AlexeyVdovin/ha-proj/SmartNode/eagle/main-01.brd

## EAGLE design SmartNode/eagle/main-01.brd (2019-10-10)

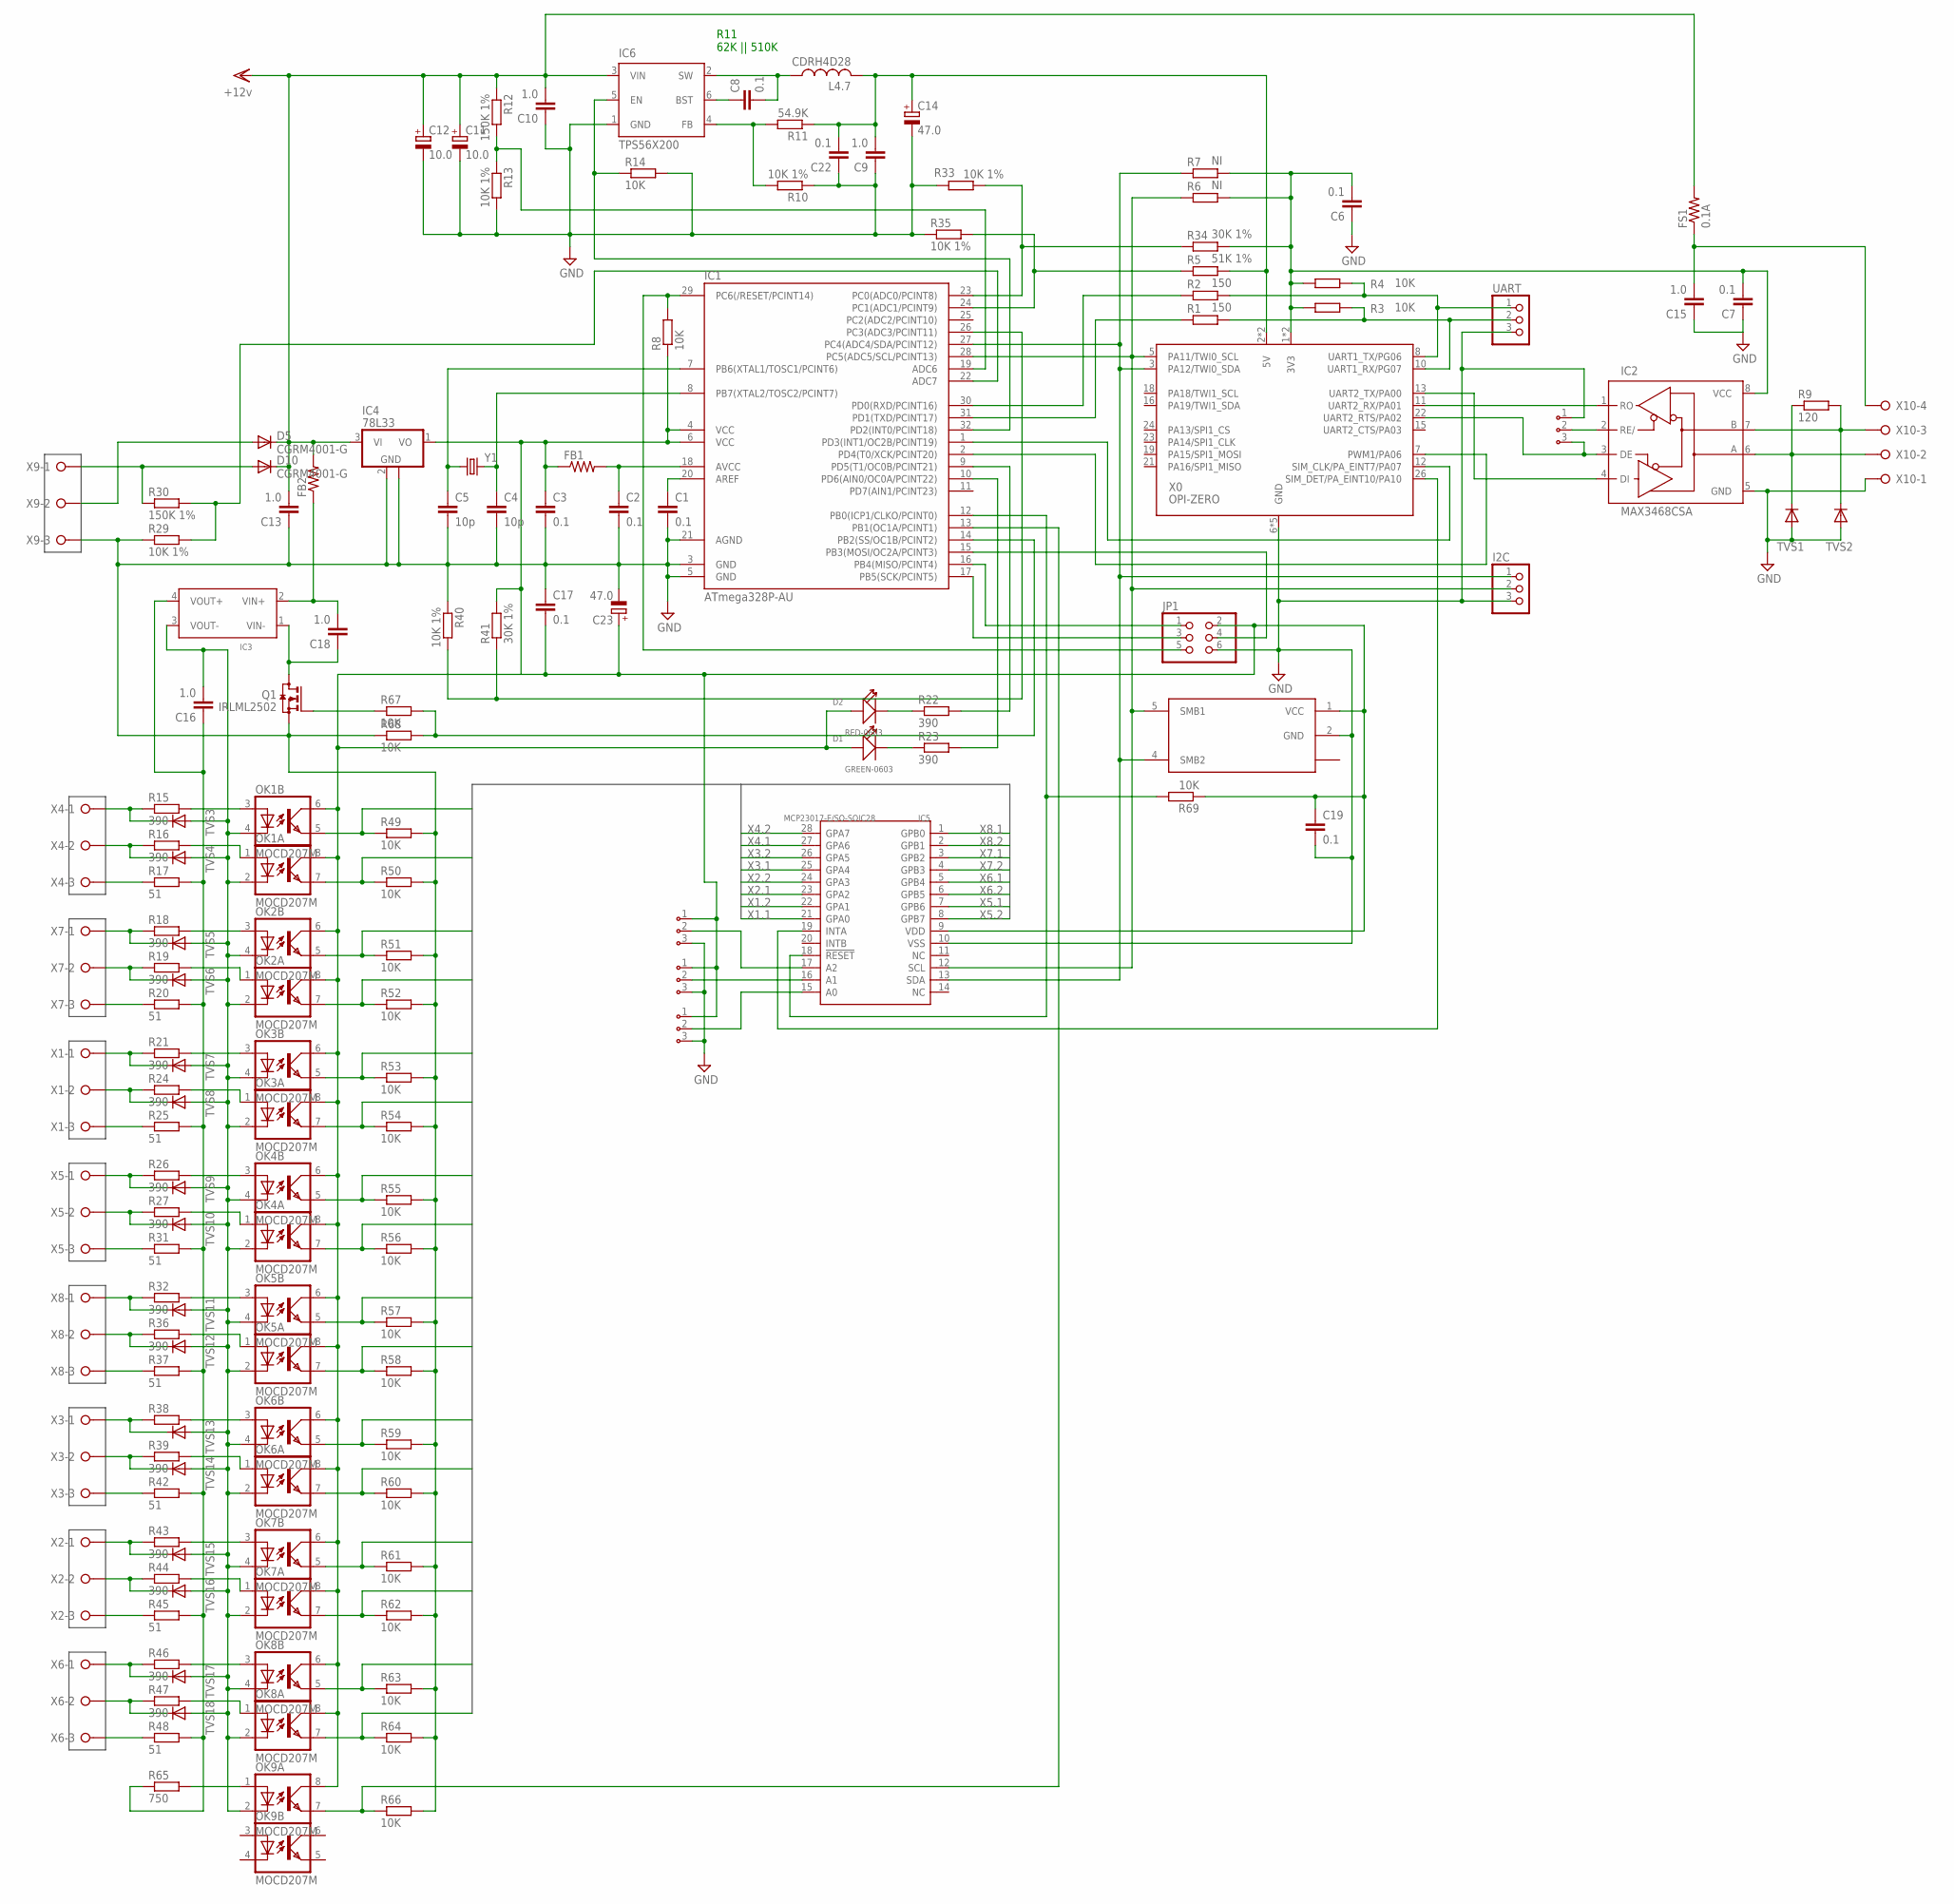
[picture p1: schematic main-01.sch]

Parts:
4: ADDR3PIN0603; 0603-3PIN
A0, A1, A2: ADDR3PIN0603; 0603-3PIN
C1, C2, C3, C17, C19: 0.1; C0603
C4, C5: 10p; C0603
C6, C7, C8, C22: 0.1; C0805
C9: 1.0; C0805
C10, C13, C15, C16, C18: 1.0; C1206
C11, C12: 10.0; C/6032-28R
C14, C23: 47.0; B/3528-21R
D1: GREEN-0603; LED-0603
D2: RED-0603; LED-0603
D5, D10: CGRM4001-G; SOD-123_MINI-SMA
FB1: R-US_R0805; R0805
FB2: R-US_R1206; R1206
FS1: 0.1A; R1210
I2C: PINHD-1X3; 1X03
IC1: ATmega328P-AU; TQFP32-08
IC2: MAX3468CSA; SO08
IC3: DC-DC-CONV-4PIN-ISOLATINGMURATA-NME-05-12-SERIES; DC-DC-MURATA-NME-05-12-SERIES
IC4: 78L33; SOT89
IC5: MCP23017-E/SO-SOIC28; SOIC28-1.27-17.9X7.5MM
IC6: TPS56X200; TSOT23-6_DDC
IC7: LTC1694; SOT23-5
JP1: PINHD-2X3; 2X03
L4.7: CDRH4D28
OK1, OK2, OK3, OK4, OK5, OK6, OK7, OK8, OK9: MOCD207M; SOIC08-FAIRCHILD
Q1: IRLML2502; SOT23
R1, R2: 150; R0603
R3, R4, R8, R14, R49, R50, R51, R52, R53, R54, R55, R56, R57, R58, R59, R60, R61, R62, R63, R64, R66, R67, R68, R69: 10K; R0603
R5: 51K 1%; R0603
R6, R7: NI; R0603
R9: 120; R1206
R10, R13, R29, R33, R35, R40: 10K 1%; R0603
R11: 54.9K; R0603
R12, R30: 150K 1%; R0603
R15, R16, R18, R19, R21, R22, R23, R24, R26, R27, R32, R36, R39, R43, R44, R46, R47: 390; R0603
R17, R20, R25, R31, R37, R42, R45, R48: 51; R0603
R34, R41: 30K 1%; R0603
R38: R-EU_R0603; R0603
R65: 750; R0603
TVS1, TVS2, TVS3, TVS4, TVS5, TVS6, TVS7, TVS8, TVS9, TVS10, TVS11, TVS12, TVS13, TVS14, TVS15, TVS16, TVS17, TVS18: DIODE-SOD323-W; SOD323-W
UART: PINHD-1X3; 1X03
X0: OPI-ZERO; OPI0
X1, X2, X3, X4, X5, X6, X7, X8, X9: W237-03P; W237-133
X10: W237-04P; W237-4P
Y1: CRYSTALHC49US; HC49US

Connections:
12V: C10.2, C11.+, C12.+, C13.2, D5.C, D10.C, FB2.2, FS1.2, IC4.3 (VI), IC6.3 (VIN), R12.1
GND: 4.1, A0.3, A1.3, A2.3, C1.2, C2.2, C3.2, C4.2, C5.2, C6.1, C7.1, C9.1, C10.1, C11.-, C12.-, C13.1, C14.-, C15.1, C17.1, C19.2, C22.1, C23.-, I2C.3, IC1.3 (GND), IC1.5 (GND), IC1.21 (AGND), IC2.5 (GND), IC4.2 (GND), IC4.2@1 (GND), IC5.10 (VSS), IC6.1 (GND), IC7.2 (GND), JP1.6, Q1.2 (S), R10.1, R13.2, R14.2, R29.1, R33.2, R35.1, R40.1, R49.2, R50.2, R51.2, R52.2, R53.2, R54.2, R55.2, R56.2, R57.2, R58.2, R59.2, R60.2, R61.2, R62.2, R63.2, R64.2, R66.2, R68.1, TVS1.A, TVS2.A, UART.3, X0.6 (GND), X0.9 (GND), X0.14 (GND), X0.20 (GND), X0.25 (GND), X9.3, X10.1
unnamed: 4.3, IC2.3 (DE), X0.22 (UART2_RTS/PA02)
unnamed: IC2.1 (RO), X0.11 (UART2_RX/PA01)
unnamed: C8.2, IC6.2 (SW), L4.7.P$1 (1)
unnamed: C4.1, IC1.8 (PB7(XTAL2/TOSC2/PCINT7)), Y1.2
unnamed: IC1.30 (PD0(RXD/PCINT16)), R2.1
unnamed: IC1.31 (PD1(TXD/PCINT17)), R1.1
unnamed: R1.2, R3.2, UART.2, X0.10 (UART1_RX/PG07)
unnamed: R2.2, R4.2, UART.1, X0.8 (UART1_TX/PG06)
unnamed: IC2.4 (DI), X0.13 (UART2_TX/PA00)
unnamed: C5.1, IC1.7 (PB6(XTAL1/TOSC1/PCINT6)), Y1.1
unnamed: IC1.24 (PC1(ADC1/PCINT9)), R5.1, R35.2
unnamed: D5.A, X9.2
unnamed: IC1.29 (PC6(/RESET/PCINT14)), JP1.5, R8.2
unnamed: OK1.3 (A), R15.2
unnamed: C1.1, IC1.20 (AREF)
unnamed: C2.1, FB1.2, IC1.18 (AVCC)
unnamed: C8.1, IC6.6 (BST)
unnamed: IC1.15 (PB3(MOSI/OC2A/PCINT3)), JP1.4
unnamed: IC1.17 (PB5(SCK/PCINT5)), JP1.3
unnamed: IC1.16 (PB4(MISO/PCINT4)), JP1.1
unnamed: IC2.6 (A), R9.1, TVS1.C, X10.2
unnamed: IC6.4 (FB), R10.2, R11.2
unnamed: IC2.7 (B), R9.2, TVS2.C, X10.3
unnamed: C15.2, FS1.1, X10.4
unnamed: IC1.19 (ADC6), R12.2, R13.1
unnamed: R15.1, TVS3.C, X4.1
unnamed: IC1.32 (PD2(INT0/PCINT18)), IC6.5 (EN), R14.1
unnamed: R16.1, TVS4.C, X4.2
unnamed: IC1.1 (PD3(INT1/OC2B/PCINT19)), X0.12 (SIM_CLK/PA_EINT7/PA07)
unnamed: R17.1, X4.3
unnamed: D10.A, R30.1, X9.1
unnamed: R18.1, TVS5.C, X7.1
unnamed: R19.1, TVS6.C, X7.2
unnamed: R20.1, X7.3
unnamed: OK2.3 (A), R18.2
unnamed: R21.1, TVS7.C, X1.1
unnamed: IC1.10 (PD6(AIN0/OC0A/PCINT22)), R23.2
unnamed: IC1.9 (PD5(T1/OC0B/PCINT21)), R22.2
unnamed: OK3.3 (A), R21.2
unnamed: R24.1, TVS8.C, X1.2
unnamed: R25.1, X1.3
unnamed: R26.1, TVS9.C, X5.1
unnamed: R27.1, TVS10.C, X5.2
unnamed: R31.1, X5.3
unnamed: R32.1, TVS11.C, X8.1
unnamed: R36.1, TVS12.C, X8.2
unnamed: R37.1, X8.3
unnamed: R38.1, TVS13.C, X3.1
unnamed: R39.1, TVS14.C, X3.2
unnamed: R42.1, X3.3
unnamed: R43.1, TVS15.C, X2.1
unnamed: R44.1, TVS16.C, X2.2
unnamed: R45.1, X2.3
unnamed: R46.1, TVS17.C, X6.1
unnamed: R47.1, TVS18.C, X6.2
unnamed: R48.1, X6.3
unnamed: OK4.3 (A), R26.2
unnamed: OK5.3 (A), R32.2
unnamed: OK6.3 (A), R38.2
unnamed: OK7.3 (A), R43.2
unnamed: IC1.22 (ADC7), R29.2, R30.2
unnamed: OK8.3 (A), R46.2
unnamed: C16.1, IC3.4 (VOUT+), R17.2, R20.2, R25.2, R31.2, R37.2, R42.2, R45.2, R48.2, R65.1
unnamed: IC1.23 (PC0(ADC0/PCINT8)), R33.1, R34.1
unnamed: OK1.1 (A), R16.2
unnamed: OK2.1 (A), R19.2
unnamed: OK3.1 (A), R24.2
unnamed: IC1.26 (PC3(ADC3/PCINT11)), R40.2, R41.1
unnamed: OK4.1 (A), R27.2
unnamed: OK5.1 (A), R36.2
unnamed: OK6.1 (A), R39.2
unnamed: OK7.1 (A), R44.2
unnamed: OK8.1 (A), R47.2
unnamed: C16.2, IC3.3 (VOUT-), OK1.2 (C), OK1.4 (C), OK2.2 (C), OK2.4 (C), OK3.2 (C), OK3.4 (C), OK4.2 (C), OK4.4 (C), OK5.2 (C), OK5.4 (C), OK6.2 (C), OK6.4 (C), OK7.2 (C), OK7.4 (C), OK8.2 (C), OK8.4 (C), OK9.2 (C), TVS3.A, TVS4.A, TVS5.A, TVS6.A, TVS7.A, TVS8.A, TVS9.A, TVS10.A, TVS11.A, TVS12.A, TVS13.A, TVS14.A, TVS15.A, TVS16.A, TVS17.A, TVS18.A
unnamed: D2.-, R22.1
unnamed: 4.2, IC2.2 (RE/)
unnamed: IC1.2 (PD4(T0/XCK/PCINT20)), X0.7 (PWM1/PA06)
unnamed: IC5.19 (INTA), X0.26 (SIM_DET/PA_EINT10/PA10)
unnamed: OK9.1 (A), R65.2
unnamed: IC1.13 (PB1(OC1A/PCINT1)), OK9.7 (EMIT), R66.1
unnamed: Q1.1 (G), R67.1
unnamed: IC1.14 (PB2(SS/OC1B/PCINT2)), R67.2, R68.2
unnamed: C18.1, IC3.1 (VIN-), Q1.3 (D)
unnamed: C18.2, FB2.1, IC3.2 (VIN+)
unnamed: IC1.12 (PB0(ICP1/CLKO/PCINT0)), IC5.18 (!RESET), R69.2
unnamed: A0.2, IC5.15 (A0)
unnamed: A1.2, IC5.16 (A1)
unnamed: A2.2, IC5.17 (A2)
unnamed: D1.-, R23.1
SCL: I2C.2, IC1.28 (PC5(ADC5/SCL/PCINT13)), IC5.12 (SCL), IC7.5 (SMB1), R6.1, X0.5 (PA11/TWI0_SCL)
SDA: I2C.1, IC1.27 (PC4(ADC4/SDA/PCINT12)), IC5.13 (SDA), IC7.4 (SMB2), R7.1, X0.3 (PA12/TWI0_SDA)
VCC: A0.1, A1.1, A2.1, C3.1, C17.2, C19.1, C23.+, D1.+, D2.+, FB1.1, IC1.4 (VCC), IC1.6 (VCC), IC4.1 (VO), IC5.9 (VDD), IC7.1 (VCC), JP1.2, OK1.6 (COL), OK1.8 (COL), OK2.6 (COL), OK2.8 (COL), OK3.6 (COL), OK3.8 (COL), OK4.6 (COL), OK4.8 (COL), OK5.6 (COL), OK5.8 (COL), OK6.6 (COL), OK6.8 (COL), OK7.6 (COL), OK7.8 (COL), OK8.6 (COL), OK8.8 (COL), OK9.8 (COL), R8.1, R41.2, R69.1
X1.1: IC5.21 (GPA0), OK3.5 (EMIT), R53.1
X1.2: IC5.22 (GPA1), OK3.7 (EMIT), R54.1
X2.1: IC5.23 (GPA2), OK7.5 (EMIT), R61.1
X2.2: IC5.24 (GPA3), OK7.7 (EMIT), R62.1
X3.1: IC5.25 (GPA4), OK6.5 (EMIT), R59.1
X3.2: IC5.26 (GPA5), OK6.7 (EMIT), R60.1
X4.1: IC5.27 (GPA6), OK1.5 (EMIT), R49.1
X4.2: IC5.28 (GPA7), OK1.7 (EMIT), R50.1
X5.1: IC5.7 (GPB6), OK4.5 (EMIT), R55.1
X5.2: IC5.8 (GPB7), OK4.7 (EMIT), R56.1
X6.1: IC5.5 (GPB4), OK8.5 (EMIT), R63.1
X6.2: IC5.6 (GPB5), OK8.7 (EMIT), R64.1
X7.1: IC5.3 (GPB2), OK2.5 (EMIT), R51.1
X7.2: IC5.4 (GPB3), OK2.7 (EMIT), R52.1
X8.1: IC5.1 (GPB0), OK5.5 (EMIT), R57.1
X8.2: IC5.2 (GPB1), OK5.7 (EMIT), R58.1
Z3V3: C6.2, C7.2, IC2.8 (VCC), R3.1, R4.1, R6.2, R7.2, R34.2, X0.1 (3V3), X0.17 (3V3)
Z5V: C9.2, C14.+, C22.2, L4.7.P$2 (2), R5.2, R11.1, X0.2 (5V), X0.4 (5V)

Notes on the sheet:
R11 62K || 510K

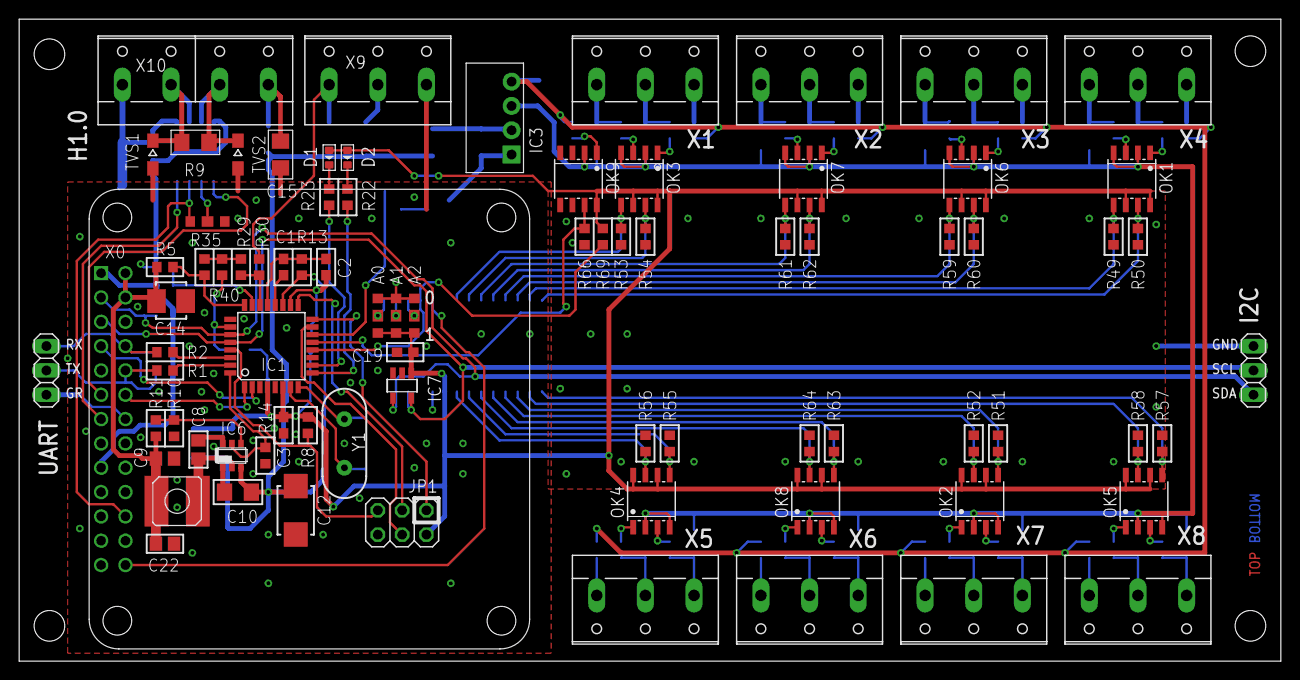
[picture p2: board main-01.brd from above]

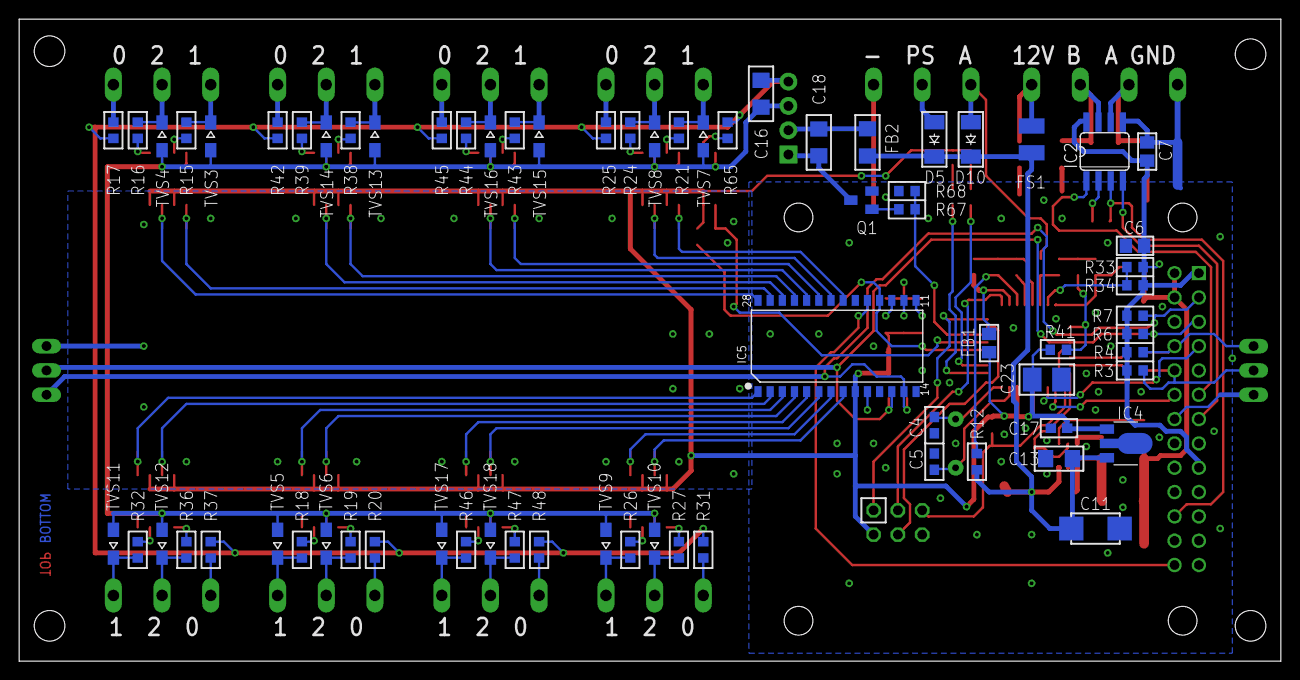
[picture p3: board main-01.brd from below]

Board: 2 copper layers, 131.8 x 67.0 mm, 151 parts (70 on the bottom side), 112 nets.
