AlexeyVdovin/ha-proj/GreenNode/host/i2c-wr.c

#include <stdio.h>
#include <errno.h>
#include <stdlib.h>
#include <fcntl.h>
#include <unistd.h>
#include <string.h>
#include <sys/ioctl.h>
#include <linux/i2c.h>
#include <linux/i2c-dev.h>


static inline __s32 i2c_smbus_access(int file, char read_write, __u8 command,
                                     int size, union i2c_smbus_data *data)
{
    struct i2c_smbus_ioctl_data args;

    args.read_write = read_write;
    args.command = command;
    args.size = size;
    args.data = data;
    return ioctl(file, I2C_SMBUS, &args);
}

static inline __s32 i2c_smbus_read_word_data(int file, __u8 command)
{
    union i2c_smbus_data data;
    if(i2c_smbus_access(file, I2C_SMBUS_READ, command, I2C_SMBUS_WORD_DATA, &data))
        return -1;
    else
        return 0x0FFFF & data.word;
}

static inline __s32 i2c_smbus_read_byte(int file)
{
	union i2c_smbus_data data;
	if (i2c_smbus_access(file,I2C_SMBUS_READ,0,I2C_SMBUS_BYTE,&data))
		return -1;
	else
		return 0x0FF & data.byte;
}

static inline __s32 i2c_smbus_write_byte(int file, __u8 value)
{
	return i2c_smbus_access(file,I2C_SMBUS_WRITE,value,
	                        I2C_SMBUS_BYTE,NULL);
}

static inline __s32 i2c_smbus_read_byte_data(int file, __u8 command)
{
	union i2c_smbus_data data;
	if (i2c_smbus_access(file,I2C_SMBUS_READ,command,
	                     I2C_SMBUS_BYTE_DATA,&data))
		return -1;
	else
		return 0x0FF & data.byte;
}

static inline __s32 i2c_smbus_write_byte_data(int file, __u8 command,
                                              __u8 value)
{
	union i2c_smbus_data data;
	data.byte = value;
	return i2c_smbus_access(file,I2C_SMBUS_WRITE,command,
	                        I2C_SMBUS_BYTE_DATA, &data);
}

int set_slave_addr(int file, int address)
{
    if (ioctl(file, I2C_SLAVE, address) < 0)
    {
        printf("Error: Could not set address to 0x%02x: %s\n", address, strerror(errno));
        return -errno;
    }
    return 0;
}

int main(int argc, char* argv[])
{
    char* devname = "/dev/i2c-0";
    int dev = open(devname, O_RDWR);
    int res = 0;
    int addr = 0x10, value = 0;

    if(dev < 0)
    {
        printf("Error %d: Can't open i2c device %s\n", errno, devname);
        exit(1);
    }

    res = set_slave_addr(dev, 0x16);

    if(res < 0)
    {
        printf("Error %d: Can't assign slave i2c address.\n", errno);
        exit(1);
    }

    if(argc < 3)
    {
        printf("Error: Missing arguments: addr, value\n");
        exit(1);
    }
    addr = (int)strtol(argv[1], NULL, 0);
    value = (int)strtol(argv[2], NULL, 0);

    res = i2c_smbus_write_byte_data(dev, addr, value);

    if(res < 0)
    {
        printf("Error %d: Can't write to i2c device.\n", errno);
        exit(1);
    }

    return 0;
}
