AlexeyVdovin/ha-proj/rsLib/include/timer.h

#ifndef _TIMER_H_
#define _TIMER_H_

#include <stdbool.h>
#include "defines.h"

#ifdef _USE_TIME_H_
#include <time.h>
#endif

void timer_init();

/* Return count of 10ms ticks */
long get_time();

/* Delay for n*10ms */
void delay_t(uchar t);

/* Delay for n sec */
void delay_s(uchar s);

/* Check timeout is expired */
bool timeout_expired(long timeout);

#endif /* _TIMER_H_ */
