AlexeyVdovin/ha-proj/(commit log)

2014-08-13 SensorNode: Initial commit
2014-08-19 SensorNode: AVR cross-compile
2014-08-20 SensorNode: Simple ping functionality
2014-08-25 rsLib: ADC implementation
2014-08-25 SensorNode: IO initialization
2014-08-26 rsLib: Fix packet structure
    [packet.c, packet.h]
2014-08-26 Fix rsGate to match new packet structure
    [rs485.c]
2014-08-26 rsLib: add power management to long delays
2014-08-26 SensorNode: Fix timer interrupts + comm debugging
    [main.c]
2014-08-31 rsLib: Improve ADC handling
2014-08-31 SensorNode: Implement ds1820 processing + command processing stub
2014-09-01 SensorNode: EEPROM config added
2014-09-01 SensorNode: initial implementation for '02 - read sensor' command
2014-09-02 rsLib: PWM module added
2014-09-02 SensorNode: Read sensors
2014-09-03 SensorNode: Initial implementation for '04 - set actuator' command
2014-09-03 rsLib: Added ds1820 sensor count
2014-09-03 SensorNode: Implemented ds1820 rescan command
2014-09-03 SensorNode: read command processing fix
    [adc.c, command.c]
2014-09-04 SensorNode: Make ds1820 read more reliable
2014-09-05 rsLib: Fix ADC mode
    [adc.c]
2014-09-05 rsLib: Extend PWM functionality + fix SensorNode
    [command.c, main.c, pwm.c, pwm.h]
2014-09-21 rsLib: Add LED display driver
2014-09-22 ControlNode: Stub implementation + build redesign
    [defines.h, led_display.c, led_display.h, main.c, sio.c, timer.c]
2014-09-22 SensorNode: build redesign
2014-09-24 rsLib: SW PWM module added
2014-09-24 ControlNode: SW PWM used + cosmetics
2014-09-30 SensorNode: Makefile fix + cosmetic changes
    [main.c, pwm.c, sw_pwm.c]
2014-09-30 rsLib/timer: fix timer overflow
    [led_display.c, led_display.h, main.c, packetio.h, timer.c, timer.h]
2014-10-03 SensorNode: Restore Timer functionality + PWM init moved to main.c
2014-10-06 rsLib/ds1820: Add custom pin support
2015-03-09 Switch to 328p
2018-09-07 Working i2c slave IO
2018-09-07 printf redirected to uart and timer fix
    [defines.h, main.c, timer.c, timer.h, twi_slave.c, twi_slave.h]
2018-09-09 ADC calibration
2018-09-09 Power monitoring
2018-09-10 Host i2c functions
2018-09-15 Reading DS18B20 temperature
2018-12-15 Reading m328 i2c registers
2018-12-15 Select i2c slave address for ds2482
2019-03-07 Fix 1W-Search and m328 bugs
    [ds2482.c, ds2482.h, main.c]
2019-03-07 Relay control on m328
2019-03-07 Fix ambiguous ‘else’
2019-03-09 Fix m328 relay control
    [main.c, twi_slave.c, twi_slave.h]
2019-03-10 Main temperature proc
2019-03-10 Sensors map
2019-03-10 Fix for temperature processing
2019-03-13 Fix relay status reporting
    [twi_slave.c]
2019-03-13 Turn OFF all realays in case of power loss
2019-03-14 Sensor mapping
2019-03-14 Fix Pi Zero shutdown in power loss case
    [main.c]
2019-03-14 Disable i2c and uart if OPiZ in Power OFF state
2019-03-14 Disable UART and TWI stub
2019-03-29 Apply T correction to sensors
    [ds2482.c]
2019-05-14 Fix i2c stuck in case of Master reset
    [main.c, twi_slave.c, twi_slave.h]
2019-10-09 SmartNode carrier board added
    [main-01.brd, main-01.sch, main-02.brd, main-02.sch]
2019-10-10 Add component values to schematic
    [main-01.brd, main-01.sch]
